Dheerajsom/pihole-zero2w-case/stl/PiHole_Base.stl

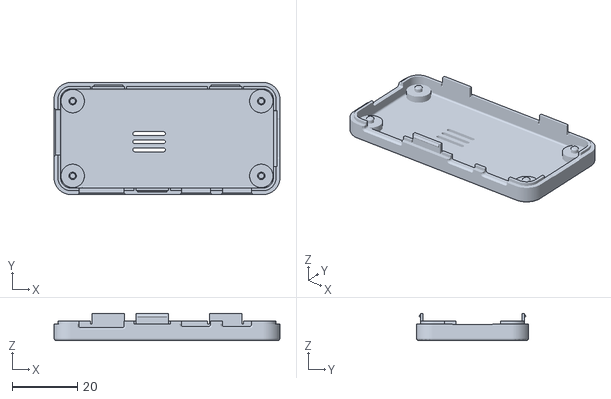
[picture p5: CAD file, 2026-10-26]
stl/PiHole_Base.stl
69.5 x 34.5 x 8.40
