Dheerajsom/pihole-zero2w-case/stl/PiHole_Lid.stl

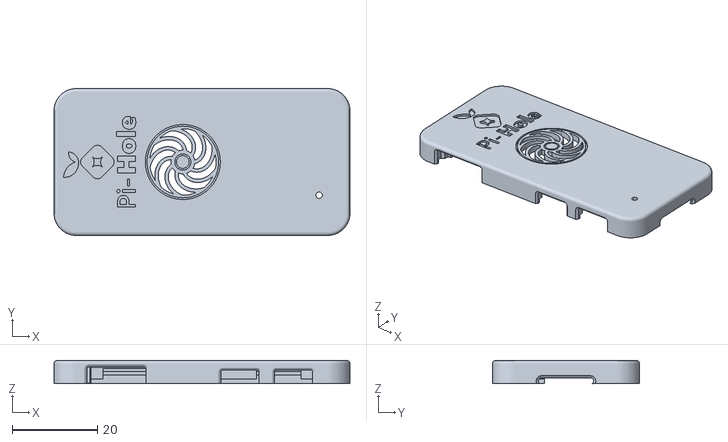
[picture p6: CAD file, 2026-10-26]
stl/PiHole_Lid.stl
69.5 x 34.5 x 5.45
