Dheerajsom/pihole-zero2w-case/(commit log)

2026-10-26 Add Pi-hole Zero 2 W resin case STLs, renders and README
    [PiHole_Base.stl, PiHole_Lid.stl]
2026-10-26 Switch to a snap-fit lid
    Replace the four M2.5 screws and captive nuts with three cantilever snap
    tabs on the base lip that catch grooves inside the lid wall. Add locating
    pins on the standoffs, leave a 0.1 mm gap under the lid clamp bosses so
    the snaps always seat, and remove the screw bores, counterbores and nut
    pockets. Re-export both STLs, refresh the renders, add base and lid
    detail images, and update the README for the new assembly.
    [PiHole_Base.stl, PiHole_Lid.stl]
